simmunity/ChickenDoorArduino/(commit log)

2019-11-17 November 17, 2017 initial beta version
    Initial beta version developed with Arduino Uno and Seeed Studio Grove shield and Grove and other vendors devices attached.
2019-11-18 Updated ino file remove erroneous set of indicator
    An old reference to setting the indicator pin in the settings() fuinction was erroneous, removed
2020-01-15 Tuned light sensor thresholds and open close gap
    Adjusted the threshold for open and close during DAY to better values for the specific sensor in my hardware (Seeed Studio Light Sensor V1) into a older Uno. The gap prevents the system from cycling at the threshold.
    [chickenDoor.ino]
